tucksravin/octagonal-led-turn-counter/docs/superpowers/plans/2026-08-16-tap-guard.md

# Tap Guard Implementation Plan

> **For agentic workers:** REQUIRED SUB-SKILL: Use superpowers:subagent-driven-development (recommended) or superpowers:executing-plans to implement this plan task-by-task. Steps use checkbox (`- [ ]`) syntax for tracking.

**Goal:** Make one broken piezo channel a nuisance instead of an outage: hysteresis re-arm, stuck-mute, rate quarantine, quiet-recovery unmute, all announced over serial and `/api/diag`.

**Architecture:** All logic lives in `octagon_core.cpp`'s `readPiezos`/new `commitFire`, so `turn_counter` and `eight` inherit it. The web layer only gains a `muted` field.

**Spec:** `docs/superpowers/specs/2026-08-16-tap-guard-design.md` — the mechanisms, constants and rationale live there; this plan is the file-by-file sequence.

**Constraints:** No compiling or flashing — the user drives the bench. Host pytest is allowed. Commit per task.

---

### Task 1: Host model and tests

**Files:** Create `tests/test_tap_guard.py`

- [ ] Port the guard state machine (armed/streak/muted/lastLoud + commitFire + winner selection) into a Python `TapGuard` class driven at 5 ms steps by per-side reading generators.
- [ ] Tests, per the spec's list: clean tap = 1 fire; 900 ms sustained ring = 1 fire; pinned input = 1 fire then muted ≤ 2.1 s and a *different* side fires normally afterward; 60 Hz hum = ≤ 8 fires, muted ≤ ~2.2 s, unmuted 5 s after hum stops; 4-tap gesture at 500 ms never mutes; 8-tap drum-roll at 300 ms mutes then self-heals; same-scan ghost loses to the bigger delta; next-scan ghost is suppressed while the disarmed winner is still hot; accepted fires alone move the global lastTapMs.
- [ ] `pytest tests/test_tap_guard.py -v` → all pass. Commit.

### Task 2: The guard in octagon_core

**Files:** Modify `firmware/libraries/octagon_core/src/octagon_core.cpp`, `octagon_core.h`

- [ ] Constants next to `TAP_DELTA`: `CHATTER_GAP_MS 400`, `CHATTER_STREAK 8`, `STUCK_MUTE_MS 2000`, `UNMUTE_QUIET_MS 5000` (values + rationale in spec).
- [ ] State next to `lastTapPerSide`: `armed[NUM_SIDES]` (init true), `fireStreak[]`, `muted[]`, `lastLoudMs[]`.
- [ ] `commitFire(i, now)` exactly as specced — debounce, disarm, streak, mute-and-swallow, `lastTapMs` only on acceptance.
- [ ] Rewrite `readPiezos` per the spec's scanner-structure section: per-side loop stamps `lastLoudMs`/re-arms/runs the EMA as today, handles unmute and stuck-mute, and collects hot **unmuted** candidates; winner path = disarmed-winner suppression → `commitFire`; opposite-pair bit requires `armed[opp]` + own `commitFire`.
- [ ] Serial prints on mute (side, cause: chatter vs stuck, unmute condition) and unmute.
- [ ] `octagon_core.h`: `bool sideMuted(uint8_t i);` next to `lastTapForSide`. Commit.

### Task 3: Surface it on the phone

**Files:** Modify `firmware/turn_counter/web_ui.cpp`, `tests/test_diag_json.py`

- [ ] `handleDiag`: append `,"muted":%u` per side (`sideMuted(i)`). Update the test's `build_diag` model to match and re-check the worst case still clears `char[768]` with > 80 bytes headroom.
- [ ] Page: in `loadDiag`'s row builder, a muted row gets `class="warn"` on the whole `<tr>` and its baseline cell reads `<baseline> · muted`.
- [ ] `pytest tests/ -v` → all pass. Commit.

### Task 4: Docs and memory

- [ ] `turn_counter_design_doc.md`: tap-detection section gains the guard paragraph + the four constants in the constants table; troubleshooting table gains "seat dead, diag shows muted → fix the channel, or 5 s of quiet restores it".
- [ ] `design_doc_simple.md` §6: one sentence — a chattering/stuck piezo mutes itself and shows on the phone's diagnostics.
- [ ] Update memory `piezo-chaotic-taps-ground`: firmware ≥ 2026-08-16 auto-mutes such a side; check `/api/diag` `muted` before bench-debugging thresholds. Commit repo docs.

### Task 5: Verification

- [ ] Ultracode adversarial review of the diff (tap-path changes are the most load-bearing code in the library); fix anything confirmed.
- [ ] User: `make compile-all` (both sketches — `eight` links against the changed library) then `make ota`.
- [ ] Bench: normal play + gesture + READY feel unchanged; drum one disc ~10 fast taps → serial `MUTED`, phone diag shows the red row, other seats still pass turns; stop → ~5 s → serial `unmuted`, seat live again.

### Done criteria

- [ ] All host tests pass (55 existing + new guard tests)
- [ ] Both sketches compile
- [ ] Bench: mute announces itself, table stays playable, unmute self-heals
