tucksravin/octagonal-led-turn-counter/doc-src/doc_style.py

# Shared WeasyPrint stylesheet for the PDF builders.
# Single source of truth: build_pdf.py (design doc) and
# build_dry_run_pdf.py (dry run) both import BASE_CSS from here.

BASE_CSS = """
@page {
    size: letter;
    margin: 0.75in 0.7in 0.85in 0.7in;
    @bottom-center {
        content: "Octagonal Turn Counter — Design Document  •  page " counter(page) " of " counter(pages);
        font-family: 'Helvetica', 'Arial', sans-serif;
        font-size: 9pt;
        color: #777;
    }
    @top-right {
        content: string(chapter);
        font-family: 'Helvetica', 'Arial', sans-serif;
        font-size: 9pt;
        color: #777;
    }
}

@page :first {
    @top-right { content: ""; }
    margin: 1.2in 0.8in 1in 0.8in;
}

@page wide {
    size: letter landscape;
    margin: 0.5in 0.5in 0.5in 0.5in;
    @bottom-center {
        content: "Octagonal Turn Counter — Design Document  •  page " counter(page) " of " counter(pages);
        font-family: 'Helvetica', 'Arial', sans-serif;
        font-size: 9pt;
        color: #777;
    }
    @top-right { content: ""; }
}

html { font-family: 'Helvetica', 'Arial', sans-serif; }

body {
    font-size: 10.5pt;
    line-height: 1.45;
    color: #1a1a1a;
}

h1 {
    font-size: 24pt;
    margin-top: 0;
    margin-bottom: 0.5em;
    color: #111;
    border-bottom: 2px solid #333;
    padding-bottom: 0.3em;
    line-height: 1.2;
    page-break-after: avoid;
    break-after: avoid;
}

h2 {
    font-size: 16pt;
    margin-top: 1.4em;
    margin-bottom: 0.4em;
    color: #111;
    page-break-after: avoid;
    break-after: avoid;
    string-set: chapter content();
}

h2:first-of-type { margin-top: 0.5em; }

h3 {
    font-size: 13pt;
    margin-top: 1.1em;
    margin-bottom: 0.35em;
    color: #222;
    page-break-after: avoid;
    break-after: avoid;
}

h4 {
    font-size: 11.5pt;
    margin-top: 0.9em;
    margin-bottom: 0.3em;
    color: #333;
    page-break-after: avoid;
    break-after: avoid;
}

h2 + p, h3 + p, h4 + p {
    page-break-before: avoid;
    break-before: avoid;
    page-break-after: avoid;
    break-after: avoid;
}

h2 + ul, h3 + ul, h4 + ul,
h2 + ol, h3 + ol, h4 + ol,
h2 + .figure, h3 + .figure, h4 + .figure,
h2 + table, h3 + table, h4 + table,
h2 + pre, h3 + pre, h4 + pre,
h2 + .callout, h3 + .callout,
h2 + blockquote, h3 + blockquote, h4 + blockquote {
    page-break-before: avoid;
    break-before: avoid;
}

.page-break {
    page-break-after: always;
    break-after: page;
    height: 0;
}

p { margin: 0.45em 0; }

p, li, td, th { orphans: 3; widows: 3; }

strong { color: #111; }

ul, ol { margin: 0.45em 0; padding-left: 1.6em; }
li { margin: 0.12em 0; }

li.task {
    list-style: none;
    margin-left: -1.3em;
}

li.task .task-box {
    display: inline-block;
    width: 1em;
    margin-right: 0.4em;
    color: #444;
}

dl {
    margin: 0.5em 0;
    display: grid;
    grid-template-columns: max-content 1fr;
    gap: 0.2em 1em;
}

dt {
    font-weight: bold;
    color: #111;
}

dd {
    margin: 0;
}

.metadata {
    background: #f7f7f5;
    border-left: 3px solid #888;
    padding: 0.8em 1.2em;
    margin: 1em 0;
    font-size: 11pt;
}

.metadata dl {
    margin: 0;
}

.callout {
    background: #f7f7f5;
    border-left: 3px solid #888;
    padding: 0.6em 1em;
    margin: 1em 0;
    font-size: 10pt;
}

.callout p { margin: 0.2em 0; }

ul.tight, ol.tight { margin: 0.3em 0; }
ul.tight li, ol.tight li { margin: 0.05em 0; }

blockquote {
    margin: 0.8em 0;
    padding: 0.5em 1em;
    border-left: 3px solid #888;
    background: #f5f5f5;
    font-size: 10pt;
}

code {
    font-family: 'Menlo', 'Consolas', 'Courier New', monospace;
    font-size: 9.5pt;
    background: #f0f0f0;
    padding: 0.05em 0.3em;
    border-radius: 2px;
}

pre {
    background: #f5f5f5;
    border: 1px solid #ddd;
    border-radius: 3px;
    padding: 0.6em 0.8em;
    font-size: 8.5pt;
    line-height: 1.35;
    overflow: hidden;
    page-break-inside: avoid;
}

pre code {
    background: transparent;
    padding: 0;
    font-size: 8.5pt;
    white-space: pre;
}

table {
    border-collapse: collapse;
    margin: 0.7em 0;
    width: 100%;
    font-size: 9.5pt;
}

thead { display: table-header-group; }

tr { page-break-inside: avoid; break-inside: avoid; }

th, td {
    border: 1px solid #bbb;
    padding: 0.32em 0.55em;
    text-align: left;
    vertical-align: top;
}

th {
    background: #e8e8e8;
    font-weight: bold;
    color: #111;
}

tr:nth-child(even) td { background: #f7f7f7; }

hr {
    border: none;
    border-top: 1px solid #999;
    margin: 1.3em 0;
}

.figure {
    margin: 1em 0;
    text-align: center;
    page-break-inside: avoid;
    break-inside: avoid;
    page-break-before: avoid;
    break-before: avoid;
}

.figure svg {
    max-width: 100%;
    height: auto;
    max-height: 5.5in;
}

.figure.full-page {
    page: wide;
    page-break-before: always;
    page-break-after: always;
    margin: 0;
    text-align: center;
}

.figure.full-page svg {
    max-width: 100%;
    max-height: 6.8in;
    width: auto;
    height: auto;
}

.figure.standalone {
    page-break-before: always;
    page-break-after: always;
    margin: 0;
    text-align: center;
}

.figure.standalone svg {
    max-width: 100%;
    max-height: 8in;
    width: auto;
    height: auto;
}

.caption {
    font-size: 9pt;
    color: #555;
    font-style: italic;
    margin-top: 0.5em;
    padding: 0 1em;
    text-align: center;
}

h2 + .figure, h3 + .figure { margin-top: 0.6em; }
"""
