tucksravin/octagonal-led-turn-counter/(commit log)

2026-05-05 different central board
2026-07-05 preflight audit fixes: fuse to DC side, solder/WAGO decisions, part numbers, costs
2026-07-05 makefile shortcuts + sketch folders for tap_light and turn_counter
    [tap_light.ino, turn_counter.ino]
2026-07-06 vscode intellisense config for the esp32-s3 arduino toolchain
2026-07-06 intellisense: expand exact sdk include roots — fixes WiFi unresolved in editor
    [gen_intellisense.py]
2026-07-20 spec: side-aware strip test + per-side LED calibration
2026-07-22 init working prototype. one mode
2026-07-22 simple power
2026-08-15 spec+plan: runtime piezo map and live OTA
    Two gaps that both mean "editing source and reflashing over USB to fix
    something on an assembled table":
    - PIEZO_PINS is const, so a crossed harness is a source edit. Give the
    piezo map the same NVS treatment the LED side table already has, found
    by a tap-guided wizard that lights each side and records which piezo
    answers.
    - turn_counter's ArduinoOTA implementation has been written all along but
    never run: placeholder SSID, no network upload path, and a boot-time
    connect that never retries.
2026-08-15 octagon_core: runtime side->piezo map, calibrated by tapping
    PIEZO_PINS was const, so a crossed harness meant editing the array and
    reflashing. sidePiezoPin[] now carries the same permutation at runtime,
    loaded from NVS "octagon"/"pmap" beside the LED side table, and validated
    as a true permutation of PIEZO_PINS so a table written by other firmware
    is ignored rather than trusted.
    runPiezoMapWizard() discovers it: light one side white, record which
    piezo answers, repeat. It reads PIEZO_PINS directly so the map being
    replaced can't confuse the wizard replacing it, retries a side when the
    tap lands on an already-claimed channel, and settles 400 ms between
    prompts so one tap's ring-down can't a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
2026-08-15 turn_counter, eight: remap command, secrets.h, OTA that recovers
    Both sketches gain a serial handler: m runs the remap wizard, p prints
    the current map.
    turn_counter's Wi-Fi credentials move to a gitignored secrets.h behind
    __has_include, with a committed secrets.example.h. Absent the file the
    SSID is empty and the radio is skipped entirely rather than dialing a
    placeholder network, so a fresh clone still compiles and runs.
    The OTA listener was only ever started inside the boot-time connect, so
    an AP that was slow or down at boot meant no OTA until the table was
    power-cycled. ArduinoOTA.begin() now sits behind otaReady and fires
    whenever the link first comes up; loop() retries a down link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
    [eight.ino, secrets.example.h, turn_counter.ino]
2026-08-15 scripts: map_piezos.py, ota_flash.py, and a test suite for them
    make map-piezos drives the board's remap wizard — autodetects the CP2102
    port, opens it without touching DTR/RTS so the board keeps the baselines
    the wizard is about to use, and turns the MAP protocol into prompts plus
    a paste-ready source line for the record.
    make ota compiles turn_counter and pushes it over Wi-Fi. ota_flash.py
    finds espota.py in whatever ESP32 core is installed, reads the OTA
    password out of secrets.h so it never reaches a Makefile or shell
    history, and checks the board is answering on port 3232 before starting
    — the difference between a clear "can't reach it" and a silent hang.
    Both keep argparse inside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
2026-08-15 docs: the remap wizard and the OTA workflow
    Credentials now point at secrets.h rather than the top of the sketch.
    The troubleshooting row for "tap on side 1 lights side 3" stops telling
    you to check PIEZO_PINS against the wiring and starts telling you to run
    make map-piezos, which is the whole point of the wizard. Bench checklist
    gains a piezo-map step and a real OTA step.
2026-08-15 ota_flash: drop the TCP pre-flight, which could never pass
    ArduinoOTA's port 3232 is UDP — ArduinoOTAClass::begin() opens a WiFiUDP,
    espota sends an invitation datagram, and the device connects back over TCP
    to receive the image. The pre-flight used socket.create_connection(), so it
    probed TCP 3232 and failed against a healthy board that had just printed
    "OTA ready". It blocked every push, not just broken ones.
    UDP has no handshake, so there is nothing a connect() could confirm. The
    check becomes an ICMP liveness test instead, which still separates "board
    is off the network" from "board is up" and leaves "is OTA listening" to
    espota's own response.
    Found on the first real push. The unit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
    [ota_flash.py]
2026-08-15 spec: phone control of mode and brightness
    A web UI on the board, reachable from any phone on the LAN with nothing
    to install. Mode is currently only reachable through the 4-tap gesture,
    which also resets the roster — so there is no way to switch CW to CCW
    without re-seating everyone. Brightness is compile-time.
    The web layer lands in its own translation unit with an explicit
    interface, so HTTP stays out of the game logic and game internals stay
    out of HTTP. Discovery is three layers deep because no single one reaches
    every phone: mDNS for Apple, a DHCP reservation for Android, and a QR
    sticker for guests.
2026-08-15 spec: add off as a control separate from brightness
    Brightness zero would mean turning the table back on lands you at a black
    slider with no way to tell broken from dark. Off is its own state instead:
    LEDs dark, brightness retained, and mode, roster, turn and ready flags all
    preserved so the game resumes exactly where it stopped.
    Not persisted — plug in = on, the principle already stated in the sketch,
    because a table that boots dark after a power cut reads as broken.
    The phone can turn it off and then leave the room, so there's a way back
    that needs no phone: four rapid taps on one side, the burst the firmware
    already detects for setup. Off and setup are mutually exclusive so the
    gestur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
2026-08-15 plan: phone control of mode, brightness and off
    Eight tasks. The web layer lands in its own translation unit behind a
    struct-and-callbacks interface, so HTTP never sees joinOrder and the game
    never sees a request object.
    Writing it out surfaced three hazards the spec missed, all of them silent
    rather than crashes:
    - applyPower(true) must use renderCurrent(), not startPlay(), or turning
    the table back on wipes a READY round's greens. Same hazard the spec
    flags for brightness, in a second place it didn't mention.
    - A 250 ms slider throttle means ~20 NVS writes per drag. Applying is
    immediate; the flash write waits 2 s for the drag to settle.
    - String::toInt() returns 0 for garbage, so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
2026-08-15 octagon_core: runtime NVS-backed brightness
    BRIGHTNESS was a compile-time 128, so changing it meant a reflash. It is
    now a percentage in NVS ("octagon"/"bri"), defaulting to 50% — raw 127,
    one step off what the table has run at all along. Both sketches read it,
    so eight honours it too.
    Percent is the stored unit because the API and the slider both speak
    percent; storing FastLED's 0-255 would make the round trip lossy.
    The write is deferred. A phone slider throttled to 250 ms would otherwise
    put ~20 writes into flash per drag, so setBrightnessPercent() applies
    immediately and brightnessPersistTick() commits once the drag has been
    quiet for two seconds.
    The floor is 5%, not 0: going fully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
2026-08-15 turn_counter: phone control of mode, brightness and off
    A WebServer on port 80 serving one self-contained page, plus five JSON
    endpoints. The web layer lives in its own translation unit behind a
    struct-and-callbacks interface: it reads NUM_SIDES and PLAYER_COLORS
    straight from octagon_core because those describe the table, but every
    game fact arrives through TableState, so it never sees joinOrder and the
    game never sees a request object.
    Off is a real state, not brightness zero. LEDs dark, everything else
    preserved. Not persisted — plug in = on. Four fast taps on one side wake
    it, reusing the burst the firmware already detects for setup; the two
    states are mutually exclusive so there's no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
2026-08-15 scripts: printable QR sticker for the web UI
    The third discovery layer. mDNS covers Apple devices and a DHCP
    reservation covers Android, but neither helps a guest who has never been
    told an address — so make qr prints something to stick under the table.
    normalize_url() is the part worth testing: bare hosts gain http:// and a
    root path, an existing http/https scheme and path survive, and anything
    else raises. A QR that silently opens a telnet handler is worse than no
    QR. Error correction is set to 'h' (~30% damage tolerance) because this
    is going somewhere it will get scuffed.
    Output is gitignored — it encodes one network's address, so it belongs to
    whoever generated it, not to the repo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
    [make_qr.py, test_make_qr.py]
2026-08-16 octagon_core: ease brightness instead of snapping
    The strip now lerps toward the target the way a web animation would —
    current += (target - current) * alpha per 16 ms frame — rather than
    running a fixed-duration tween. The phone slider retargets up to four
    times a second while dragging, and a tween has to restart on every one of
    those, which stutters. Smoothing just follows, and eases out for free.
    FastLED.setBrightness() does nothing until the next show(), and in steady
    play nothing redraws, so the tick issues its own show() — re-sending the
    frame already in leds[] at the new scale, no re-render. It's gated to one
    step per frame because a show() blocks ~7 ms bit-banging 221 pixels,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
    [eight.ino, turn_counter.ino]
2026-08-16 docs: correct constants that drifted from the firmware
    The config table described a firmware that hasn't existed for a while:
    - TAP_DELTA listed as 1000 in the table and 1500 in the Phase 7 text; it
    has been 720 since the 2026-07-28 bench recordings. Both fixed, and the
    table now records where 720 came from.
    - LEDS_PER_SIDE still had a row. It was removed when per-side counts moved
    into the calibrated sideLedCounts[8] table, since corner cuts make sides
    unequal. Replaced with rows for that table and for sidePiezoPin[8].
    - SETUP_EXIT_IDLE_MS (3000) is SETUP_JOIN_IDLE_MS (5000), and the two mode
    demo timings weren't documented at all.
    The Phase 2 bench procedure was worse than stal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
2026-08-16 spec: setup lock + OTA diagnostics, and two phone-only timed modes
    Two specs, sequenced. The first covers three fixes around setup mode:
    a read-only /api/diag endpoint (piezo baselines, per-side last tap, heap,
    RSSI), a persisted setup lock that refuses the four-tap gesture while lit
    but never while dark, and a derived MODE_ABORT_IDLE_MS so phase 1 aborts
    after exactly one demo rotation instead of replaying the opening mode.
    The second adds a countdown timer and a time-share mode, both settable
    only from the phone. MODE_DIAL_COUNT splits what the table's dial demos
    from what applyMode() accepts, which is why the abort constant derives
    from the dial count in the first spec rather than MODE_C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
2026-08-16 spec: setup lock is RAM-only, cleared by a power cycle
    Not persisting it is the escape hatch: a locked table with Wi-Fi down has
    no phone and no gesture, so unplug-replug has to work. Mirrors tableLit,
    which is already unpersisted for the same reason. Drops the serial 'l'
    command the persisted version needed.
2026-08-16 turn_counter: countdown timer and time-share modes
2026-08-16 web_ui, docs: timer slider, time-share readout, /api/timer
2026-08-16 turn_counter: consume refused setup bursts
    The spec promised a refused burst is consumed; the code left tapsInBurst
    at 4, so on a locked table every further tap in the window re-fired the
    amber flash, and the first tap after an unlock opened setup by itself.
    Found from the bench symptom: tap setup "blinking forever".
    Also relabel the lock button to always name its action (Lock setup /
    Unlock setup) — "Setup locked" read as a command as much as a state.
2026-08-16 turn_counter, web_ui: fix 13 defects from the adversarial review
    Setup path: entry clocks are anchored to the tap's whenMs instead of a
    fresh millis(), so a same-scan opposite-pair ghost can no longer wrap the
    grace window and skip phase 1, and the first demo frame no longer
    underflows and advances the dial past the documented CW fallback. Aborts
    now restore gameMode (a phase-2 commit is RAM-only), serial 'm' mid-setup
    aborts properly instead of stranding the emptied roster, the ARB demo
    re-deals per session, and a 3-minute session ceiling unwedges the table
    if a chattering piezo keeps refreshing lastAnyTapMs.
    Timed modes: enterSetupMode banks the live turn (an idle abort was
    silently disca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
    [test_timed_modes.py, turn_counter.ino, web_ui.cpp]
2026-08-16 spec+plan: tap guard — hysteresis, stuck-mute, rate quarantine
2026-08-16 octagon_core: tap guard — hysteresis re-arm, stuck-mute, rate quarantine
2026-08-16 tap guard v2: duty-cycle quarantine + muted-aware game routing
    Adversarial review of v1 confirmed four majors sharing one root: rate
    bands overlap human play in both directions. An eager wake+setup burst
    muted a healthy seat on the tap that should have opened setup; a 450 ms
    metronomic fault evaded all three mechanisms and re-created the setup
    wedge; the chatter mute's 7 accepted fires walked the whole setup flow
    and let the join-idle exit persist a phantom one-seat roster to NVS; and
    nothing ever consulted sideMuted(), so the turn parked on a muted seat.
    The discriminator is now loudness duty (one ~1 s EMA per side, mute at
    ~38%, unmute at ~5%): taps top out ~10% even machine-gunned, hum s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
2026-09-04 spec: the-bench monorepo — migrate the turn counter with history
    Design for a workshop monorepo at ~/Documents/GitHub/the-bench, with this
    project as its first occupant under projects/ and a shared bench layer
    (inventory, lore, conventions, adding-a-project) at the root.
    Grounded in a filesystem audit that corrected three assumptions:
    - The stray erp-industrial clone must be deleted, not relocated — the
    destination is already the live reddoorla clone, and the stray holds no
    unique objects (its tip is an ancestor of the live main).
    - git subtree must read the LOCAL path: origin/main is 6 commits behind, and
    those 6 are the whole tap guard v2 feature. A subtree from the GitHub URL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
2026-09-04 plan: the-bench migration — 12 tasks, board gates before deletion
    Phased implementation of the monorepo spec. Ordering constraints that are not
    negotiable: cleanups commit before the subtree so they ride into history; the
    subtree runs before the hand-copies (it refuses an existing prefix); and the
    board gates run before the old checkout is deleted, because nothing on the
    laptop proves secrets.h landed intact.
    Verification gates derive their numbers from the source repo rather than
    hardcoding them, since every commit between now and the migration shifts the
    counts and the .gitignore line numbers.
2026-09-04 cleanup: clear the 2026-07-14 morning report's standing to-dos
    - widen the .gitignore _build_*.html entries; three siblings were tracked
    while two exact paths were ignored, which was just inconsistent
    - delete the stray 581 KB protoboard_layout.svg.png (render accident from
    Jul 9, referenced nowhere outside the report that flagged it)
    - swap the retired 'letsplayagame' OTA password out of the test fixture; it
    is dead (turn_counter.ino:25 defaults OTA_PASSWORD "") but reads as a live
    credential, and this project is about to move to a public monorepo
    [test_ota_flash.py]
